PRNicovich/cheesoSPIM/output/balsaEnd.png

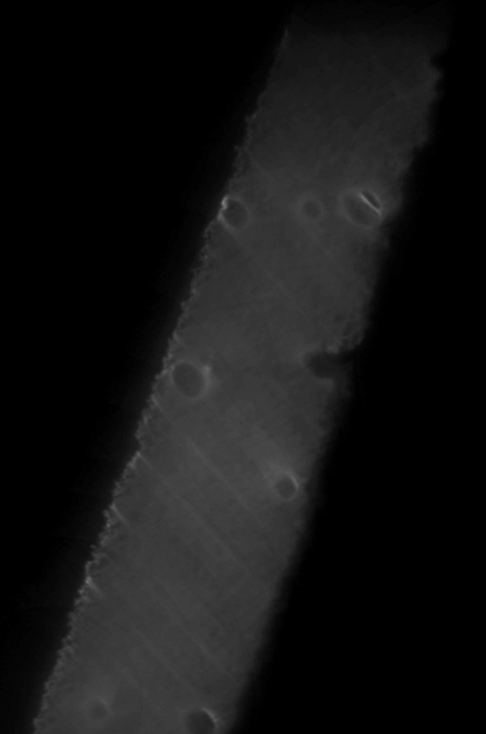
output/balsaEnd.png
