PRNicovich/cheesoSPIM/output/dyeSolution.jpg

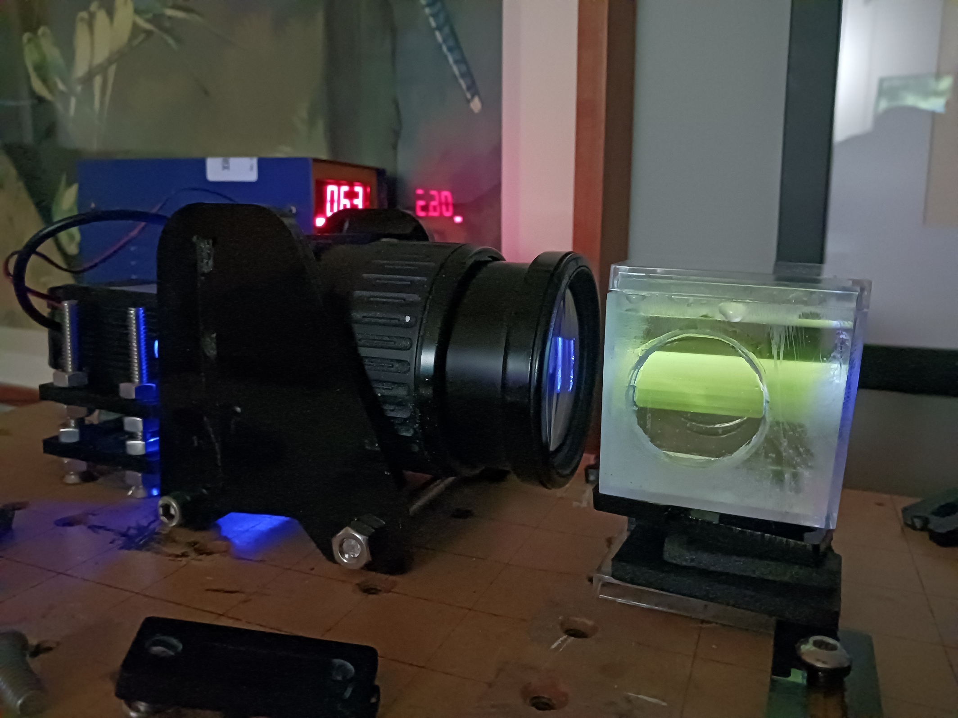
output/dyeSolution.jpg
