PRNicovich/cheesoSPIM/output/lens.jpg

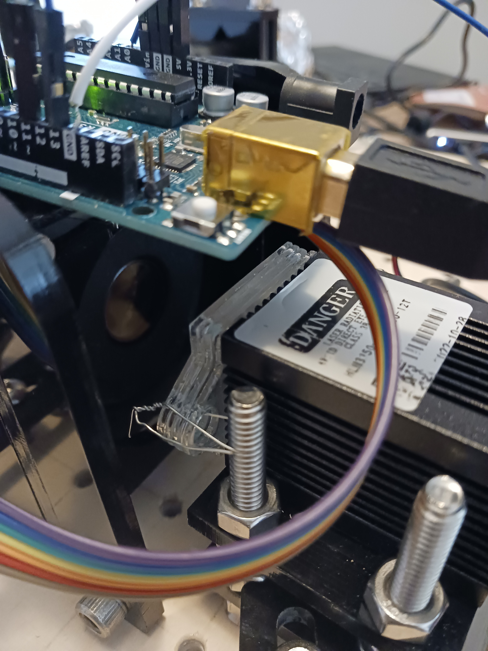
output/lens.jpg
