PRNicovich/cheesoSPIM/output/tungOil.jpg

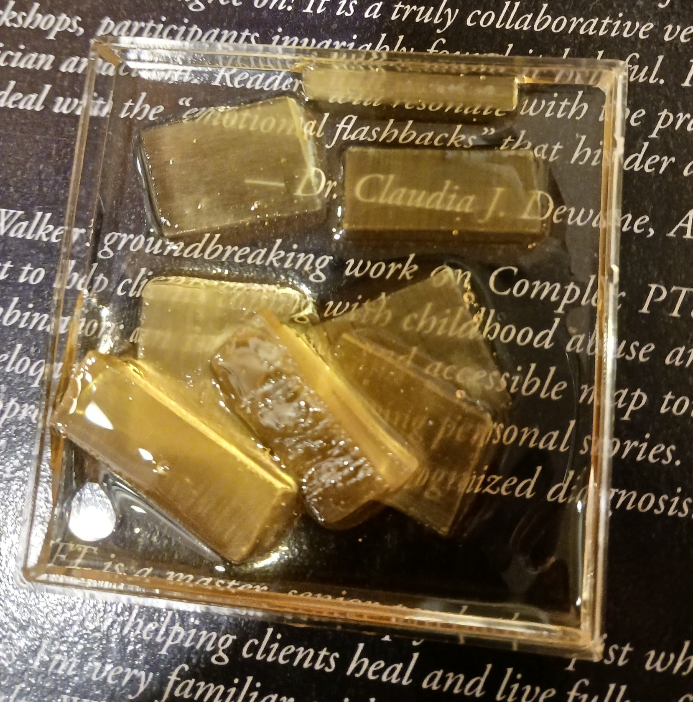
output/tungOil.jpg
