PRNicovich/cheesoSPIM/output/vacPump.jpg

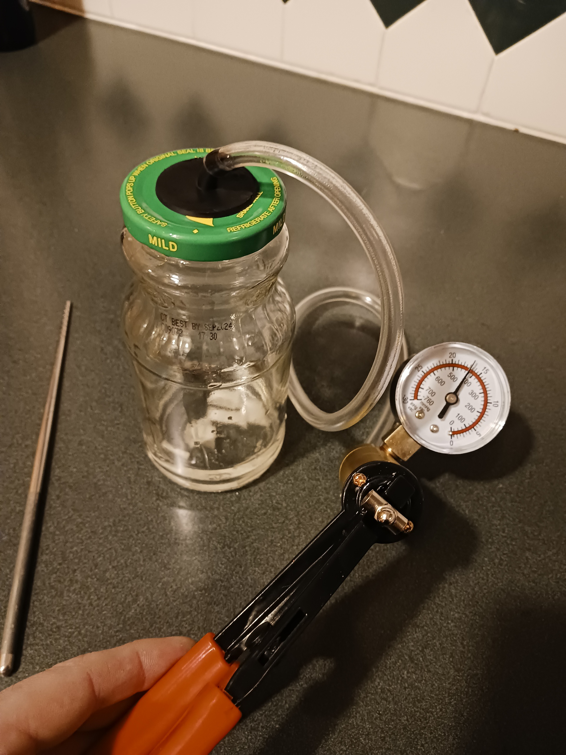
output/vacPump.jpg
